DavidMFlynn/SimpleServoCtrl16/SimpleServoPS_PCB/SimpleServoCtrlrA.sch.pdf

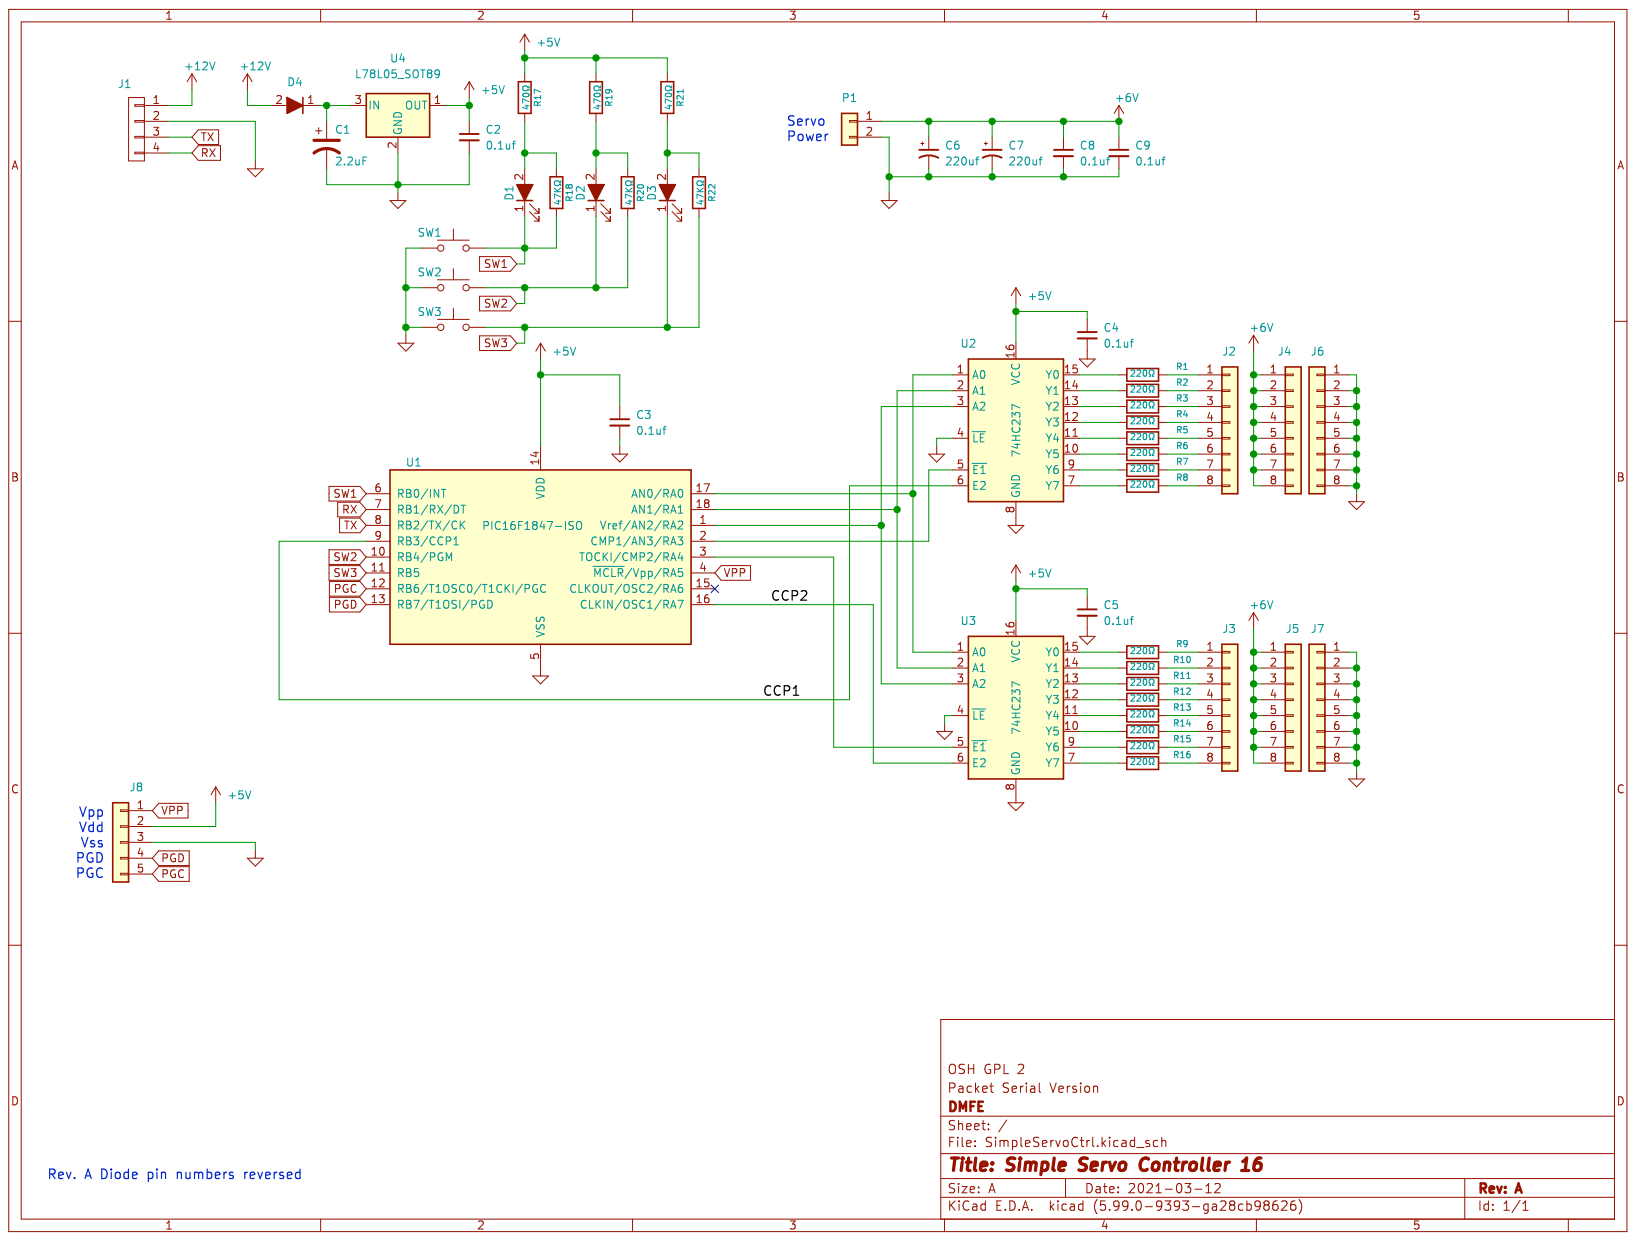
[picture p1: page 1]
