DavidMFlynn/SimpleServoCtrl16/SimpleServoPCB/SimpleServoCtrlTop.pdf

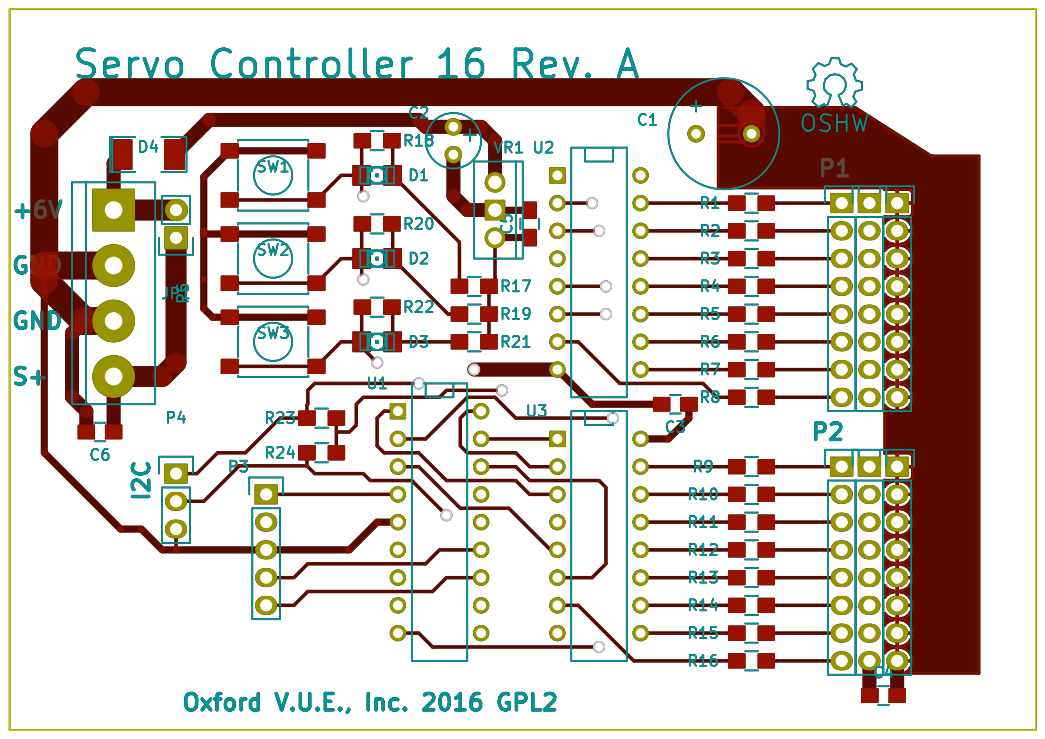
[picture p2: page 1]
