DavidMFlynn/SimpleServoCtrl16/SimpleServoPS_PCB/SimpleServoCtrl.sch.pdf

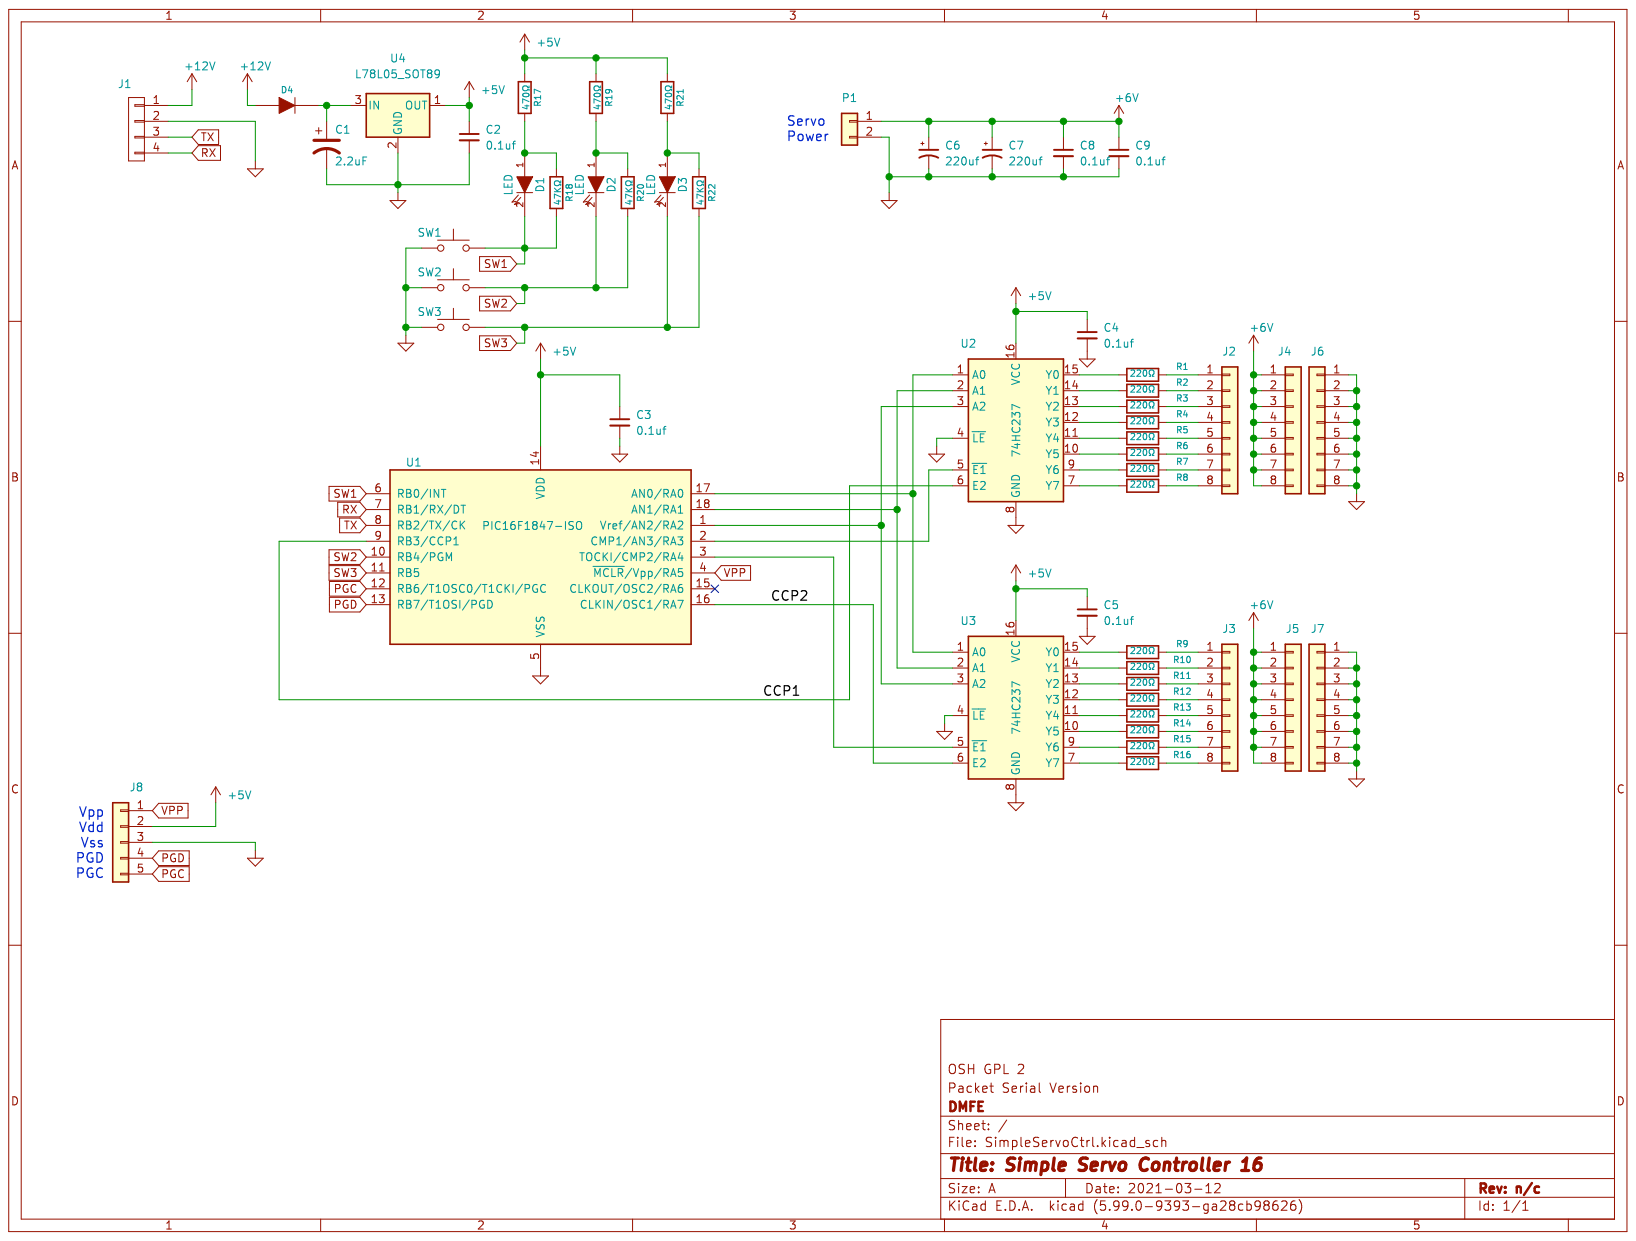
[picture p3: page 1]
