DavidMFlynn/SimpleServoCtrl16/SimpleServoPCB/SimpleServoCtrl.sch.pdf

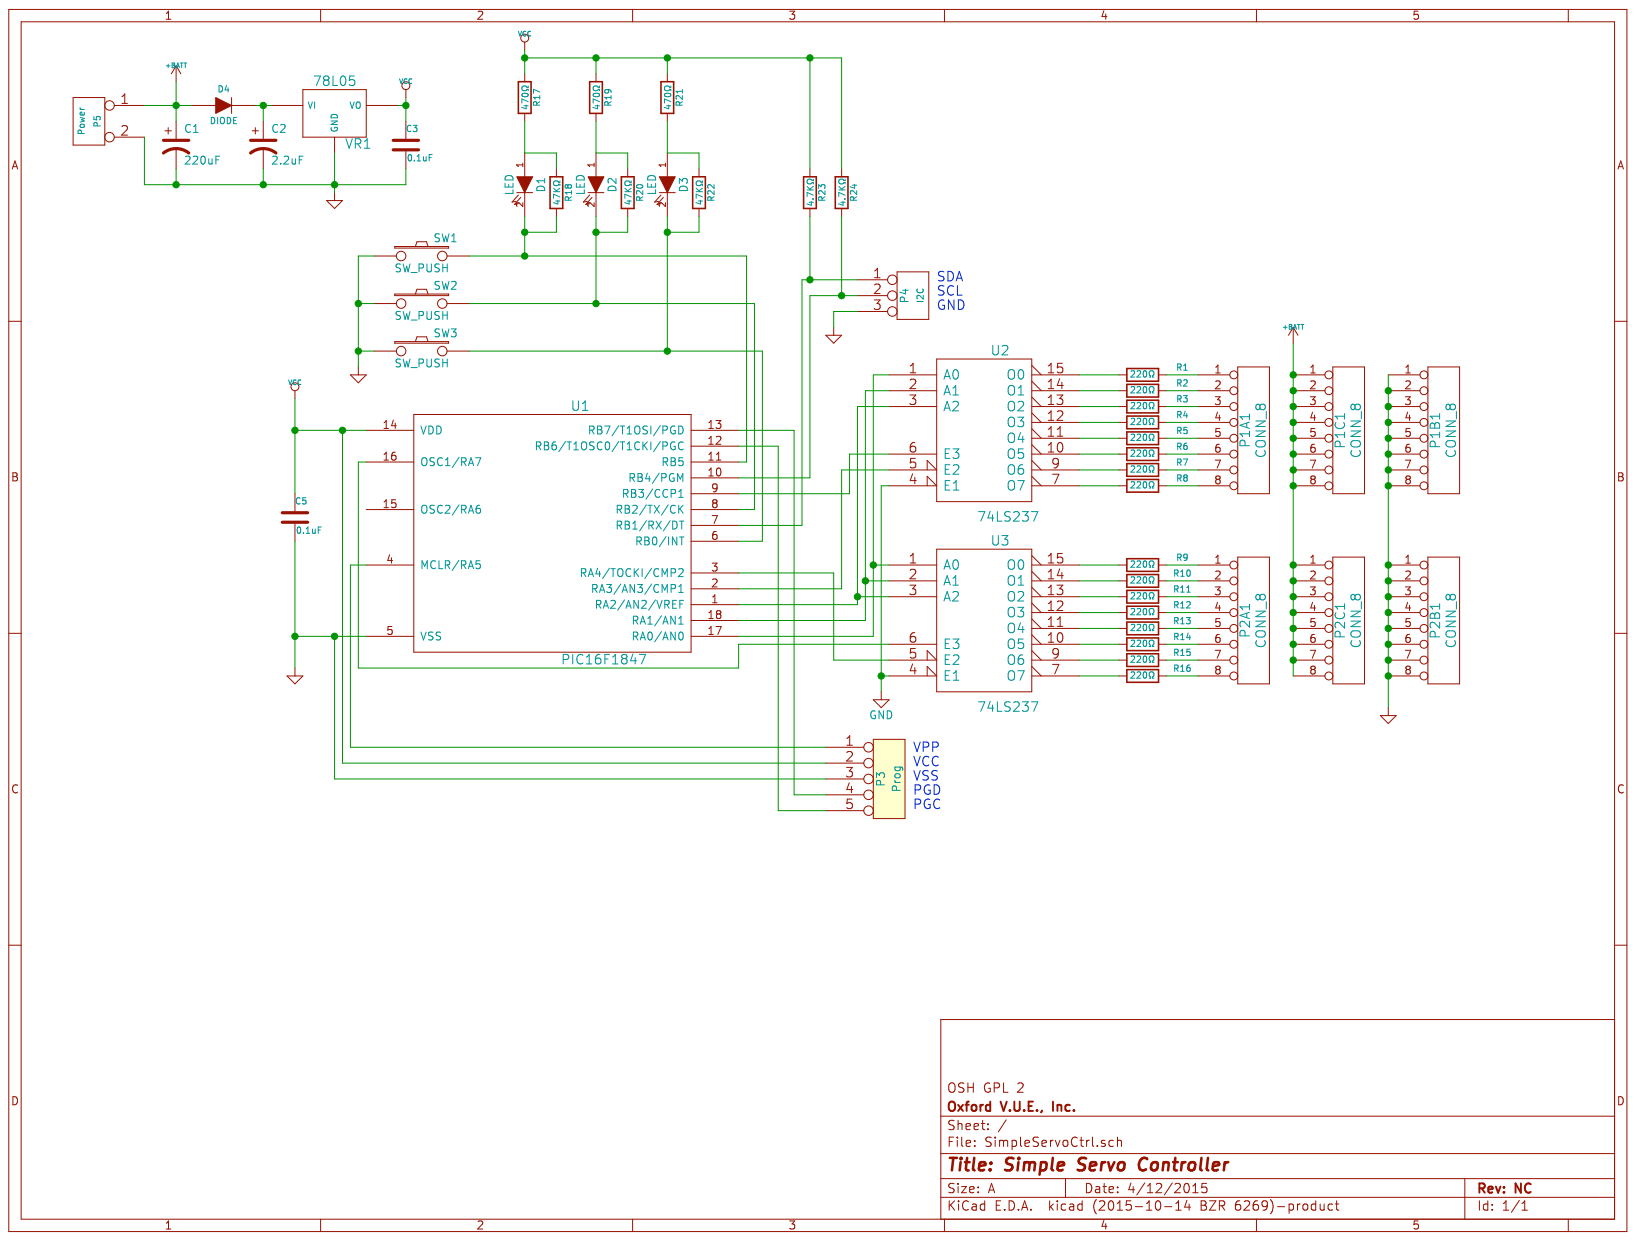
[picture p4: page 1]
