DavidMFlynn/SimpleServoCtrl16/SimpleServoPS_PCB/SimpleServoCtrl.kicad_pcb

## KiCad design SimpleServoPS_PCB/SimpleServoCtrl.kicad_pcb (2021-04-02)

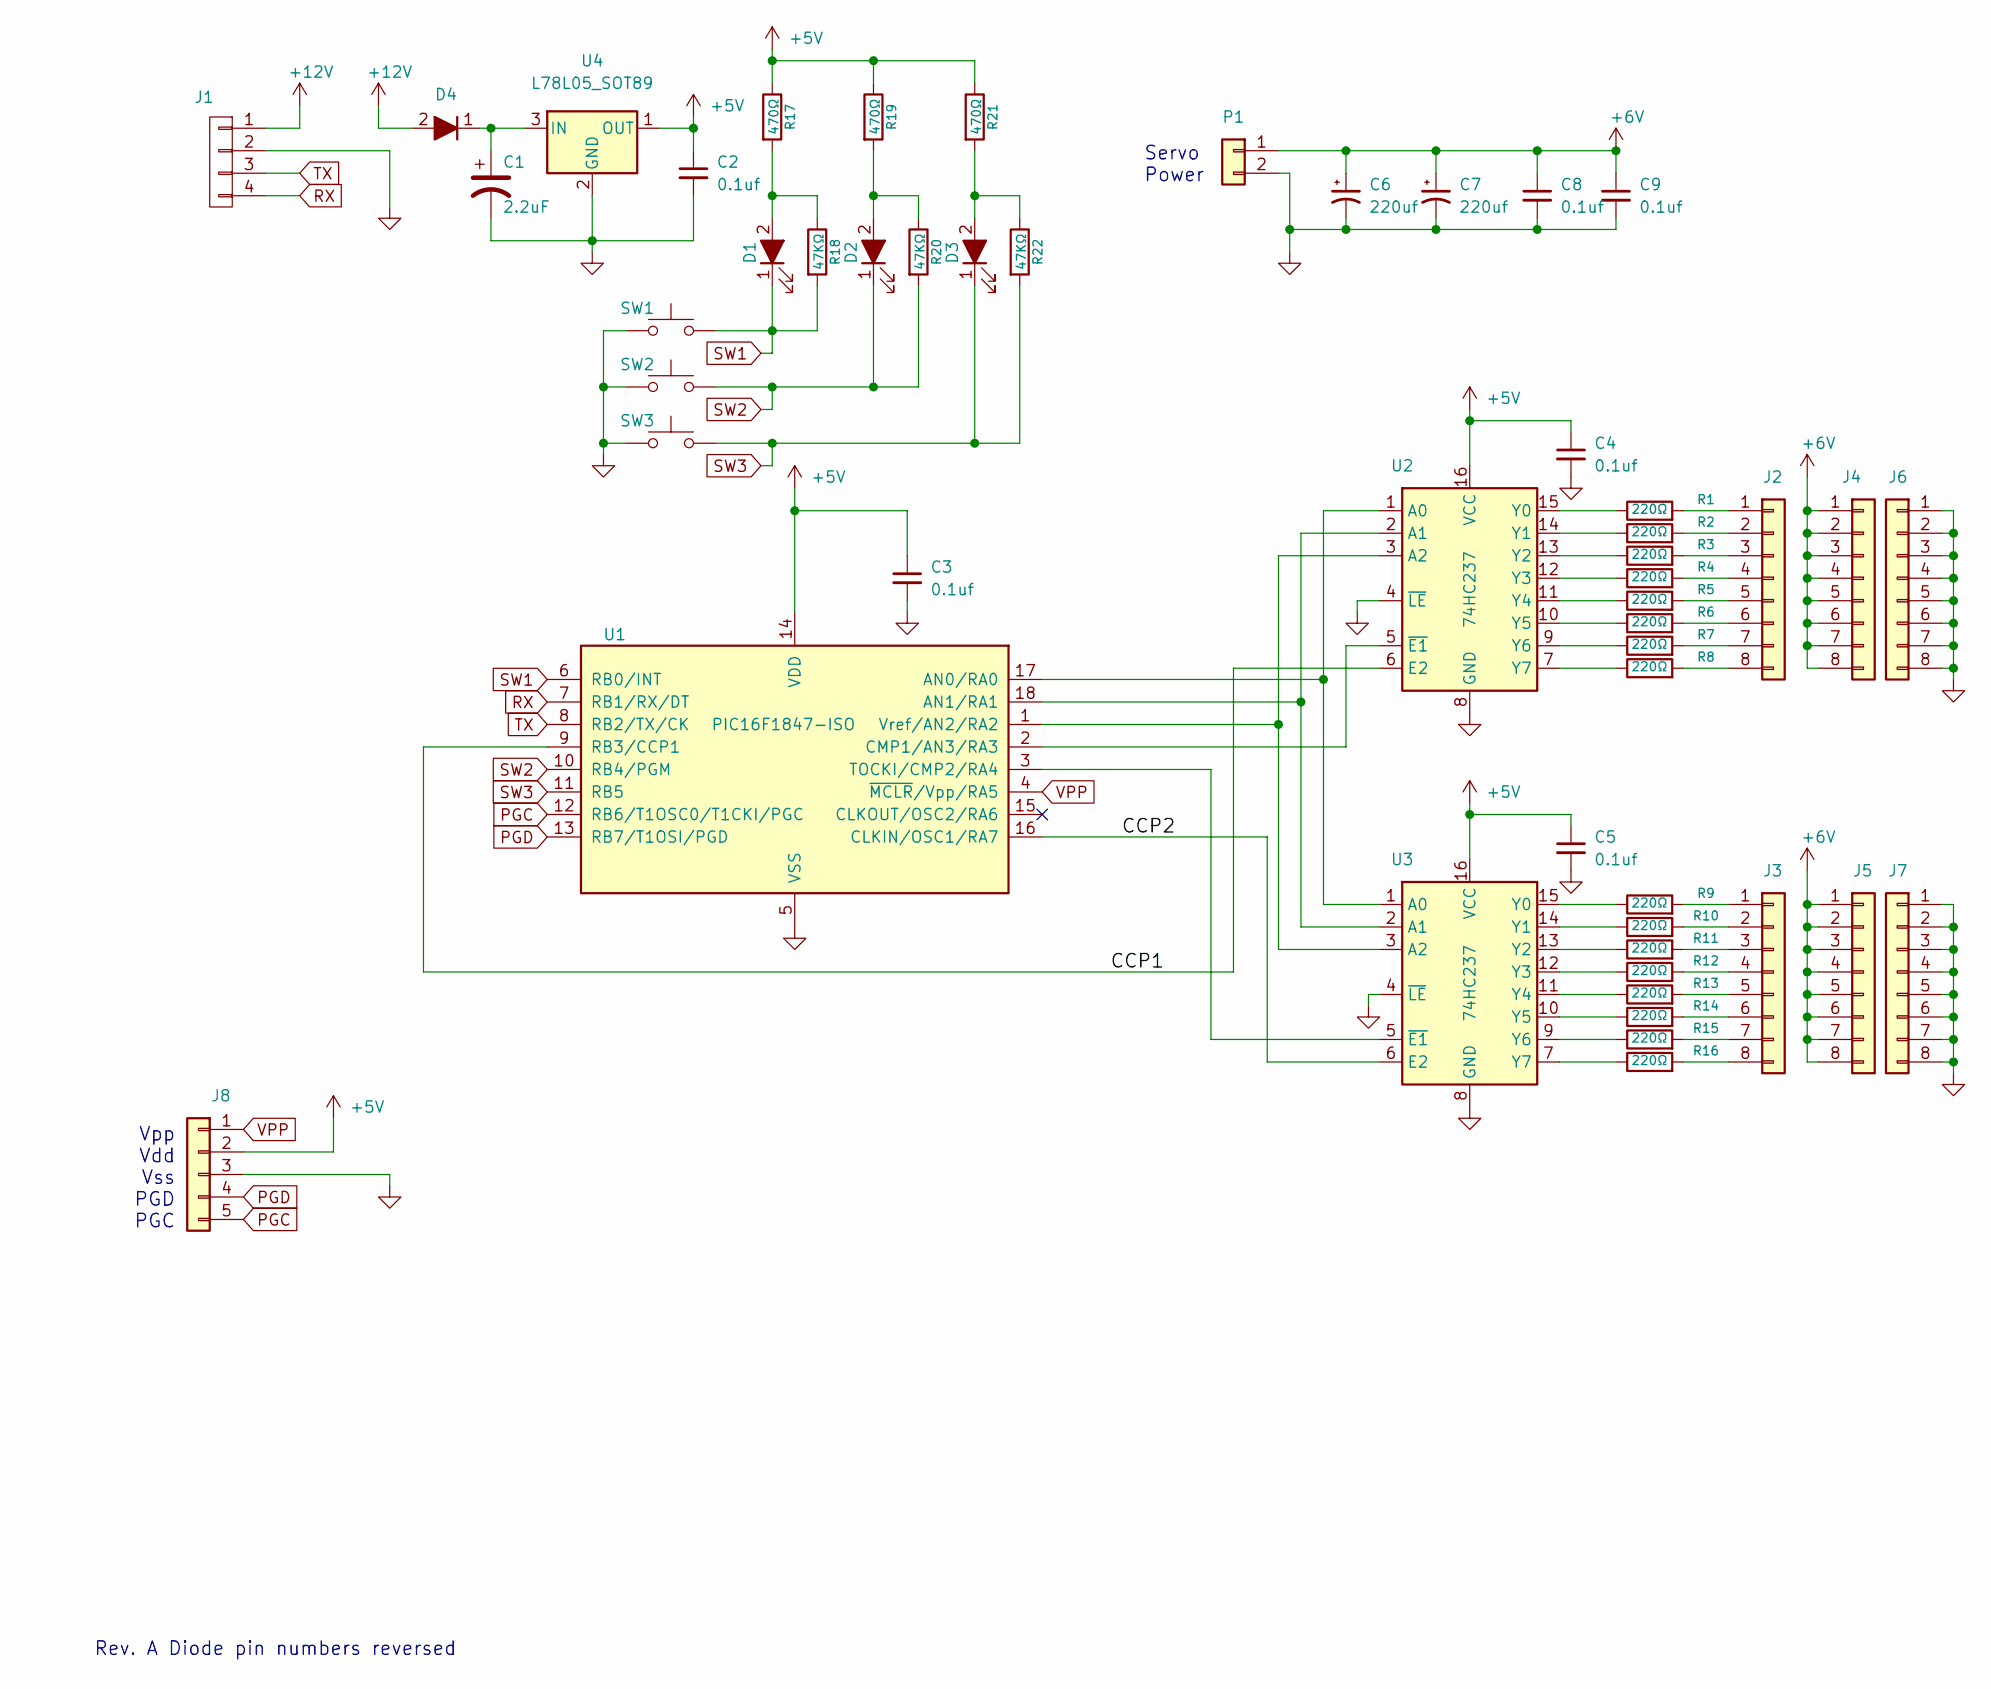
[picture p5: schematic SimpleServoCtrl.kicad_sch, Simple Servo Controller 16]

Parts:
C1: 2.2uF; CP_Radial_D5.0mm_P2.00mm
C2, C3, C4, C5, C8, C9: 0.1uf; C_0805_2012Metric_Pad1.18x1.45mm_HandSolder
C6, C7: 220uf; CP_Radial_D10.0mm_P5.00mm
D1, D2, D3: LED
D4: D_Filled
J1: CONN_01X04; Molex_KK-254_AE-6410-04A_1x04_P2.54mm_Vertical
J2, J3, J4, J5, J6, J7: Conn_01x08; PinHeader_1x08_P2.54mm_Vertical
J8: Conn_01x05; PinHeader_1x05_P2.54mm_Vertical
P1: Conn_01x02; PhoenixContact_MSTBVA_2,5_2-G-5,08_1x02_P5.08mm_Vertical
R1, R2, R3, R4, R5, R6, R7, R8, R9, R10, R11, R12, R13, R14, R15, R16: 220Ω; R_0805_2012Metric_Pad1.20x1.40mm_HandSolder
R17, R19, R21: 470Ω; R_0805_2012Metric_Pad1.20x1.40mm_HandSolder
R18, R20, R22: 47KΩ; R_0805_2012Metric_Pad1.20x1.40mm_HandSolder
SW1, SW2, SW3: SW_Push; SW_SPST_FSMSM
U1: PIC16F1847-ISO; SOIC-18W_7.5x11.6mm_P1.27mm
U2, U3: 74HC237; SO-16_5.3x10.2mm_P1.27mm
U4: L78L05_SOT89; SOT-89-3

Connections:
+5V: C2.1, C3.1, C4.1, C5.1, J8.2, R17.1, R19.1, R21.1, U1.14 (VDD), U2.16 (VCC), U3.16 (VCC), U4.1 (OUT)
+6V: C6.1, C7.1, C8.1, C9.1, J4.1, J4.2, J4.3, J4.4, J4.5, J4.6, J4.7, J4.8, J5.1, J5.2, J5.3, J5.4, J5.5, J5.6, J5.7, J5.8, P1.1
+12V: D4.2 (A), J1.1
/CCP1: U1.9 (RB3/CCP1), U2.6 (E2)
/CCP2: U1.16 (CLKIN/OSC1/RA7), U3.6 (E2)
GND: C1.2, C2.2, C3.2, C4.2, C5.2, C6.2, C7.2, C8.2, C9.2, J1.2, J6.1, J6.2, J6.3, J6.4, J6.5, J6.6, J6.7, J6.8, J7.1, J7.2, J7.3, J7.4, J7.5, J7.6, J7.7, J7.8, J8.3, P1.2, SW1.1, SW2.1, SW3.1, U1.5 (VSS), U2.4 (~LE), U2.8 (GND), U3.4 (~LE), U3.8 (GND), U4.2 (GND)
unnamed: C1.1, D4.1 (K), U4.3 (IN)
unnamed: J2.1, R1.2
unnamed: J2.2, R2.2
unnamed: J2.3, R3.2
unnamed: J2.4, R4.2
unnamed: J2.5, R5.2
unnamed: J2.6, R6.2
unnamed: J2.7, R7.2
unnamed: J2.8, R8.2
unnamed: J3.1, R9.2
unnamed: J3.2, R10.2
unnamed: J3.3, R11.2
unnamed: J3.4, R12.2
unnamed: J3.5, R13.2
unnamed: J3.6, R14.2
unnamed: J3.7, R15.2
unnamed: J3.8, R16.2
unnamed: R1.1, U2.15 (Y0)
unnamed: R2.1, U2.14 (Y1)
unnamed: R3.1, U2.13 (Y2)
unnamed: R4.1, U2.12 (Y3)
unnamed: R5.1, U2.11 (Y4)
unnamed: R6.1, U2.10 (Y5)
unnamed: R7.1, U2.9 (Y6)
unnamed: R8.1, U2.7 (Y7)
unnamed: R9.1, U3.15 (Y0)
unnamed: R10.1, U3.14 (Y1)
unnamed: R11.1, U3.13 (Y2)
unnamed: R12.1, U3.12 (Y3)
unnamed: R13.1, U3.11 (Y4)
unnamed: R14.1, U3.10 (Y5)
unnamed: R15.1, U3.9 (Y6)
unnamed: R16.1, U3.7 (Y7)
unnamed: D1.2 (A), R17.2, R18.1
unnamed: D2.2 (A), R19.2, R20.1
unnamed: D3.2 (A), R21.2, R22.1
unnamed: U1.1 (Vref/AN2/RA2), U2.3 (A2), U3.3 (A2)
unnamed: U1.2 (CMP1/AN3/RA3), U2.5 (~E1)
unnamed: U1.3 (TOCKI/CMP2/RA4), U3.5 (~E1)
unnamed: U1.17 (AN0/RA0), U2.1 (A0), U3.1 (A0)
unnamed: U1.18 (AN1/RA1), U2.2 (A1), U3.2 (A1)
PGC: J8.5, U1.12 (RB6/T1OSC0/T1CKI/PGC)
PGD: J8.4, U1.13 (RB7/T1OSI/PGD)
RX: J1.4, U1.7 (RB1/RX/DT)
SW1: D1.1 (K), R18.2, SW1.2, U1.6 (RB0/INT)
SW2: D2.1 (K), R20.2, SW2.2, U1.10 (RB4/PGM)
SW3: D3.1 (K), R22.2, SW3.2, U1.11 (RB5)
TX: J1.3, U1.8 (RB2/TX/CK)
VPP: J8.1, U1.4 (~MCLR~/Vpp/RA5)

Notes on the sheet:
Vpp Vdd Vss PGD PGC
Rev. A Diode pin numbers reversed
Servo Power

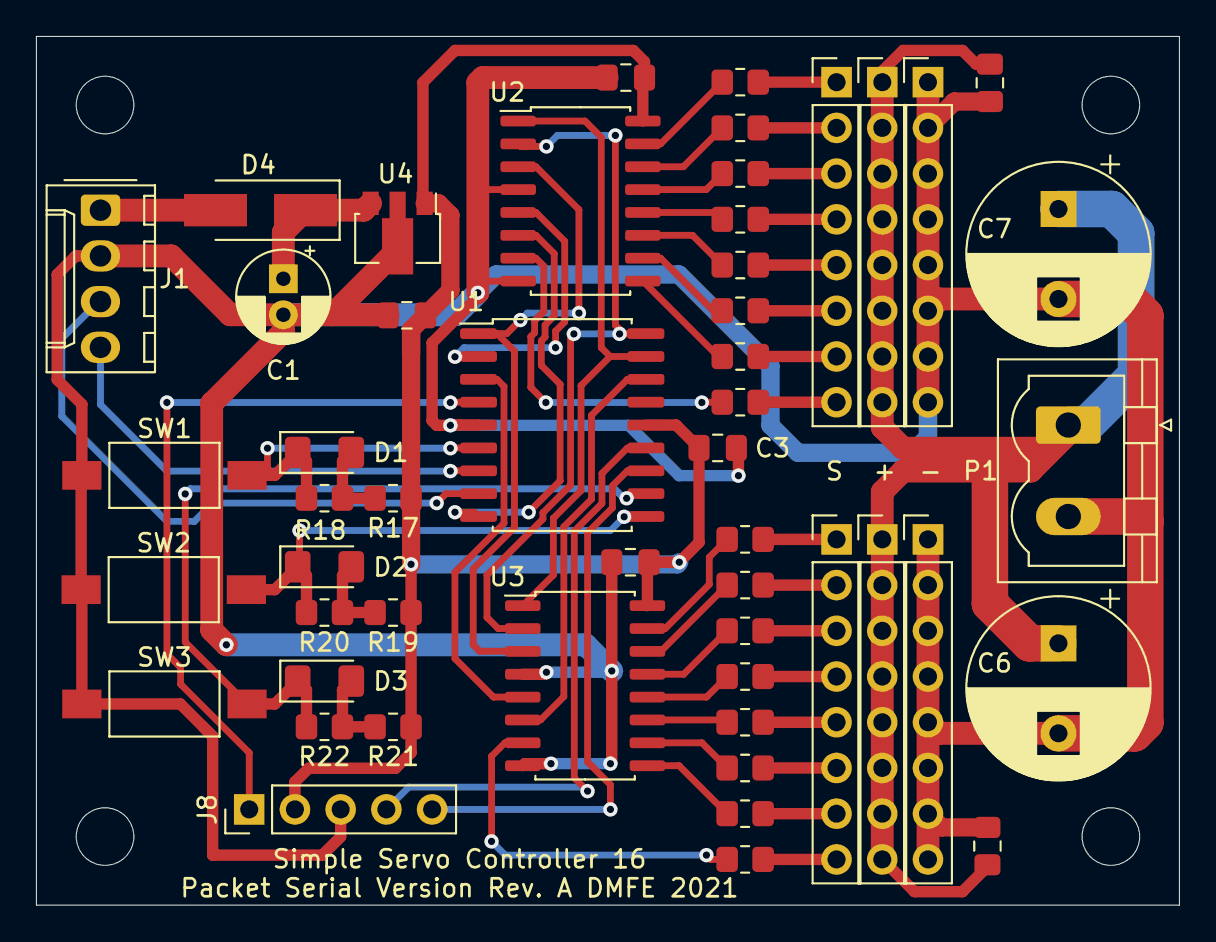
[picture p6: board SimpleServoCtrl.kicad_pcb from above]

Board: 2 copper layers, 63.5 x 48.3 mm, 55 parts (0 on the bottom side), 55 nets.

Other parts of the board:
H1, H2, H3, H4: MountingHole_3.2mm_M3
