DavidMFlynn/SimpleServoCtrl16/(commit log)

2015-11-12 First working code
    [SimpleServoCtrl.kicad_pcb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]
2015-11-20 Worked on I2C Rx/Tx
    Ready to write a master and test the I2C
2021-03-13 Added Packet Serial version
    [SimpleServoCtrl-2021-03-12-15-38-45.sch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]
2021-04-02 Rev A
    [SimpleServoCtrl-B_Cu.gbl, SimpleServoCtrl-B_Mask.gbs, SimpleServoCtrl-B_Silkscreen.gbo, SimpleServoCtrl-Edge_Cuts.gm1, SimpleServoCtrl-F_Cu.gtl, SimpleServoCtrl-F_Mask.gts, SimpleServoCtrl-F_Silkscreen.gto, SimpleServoCtrl.drl]
