DavidMFlynn/SimpleServoCtrl16/(notices)

Notices in the files:
SimpleServoPS_PCB/rescue-backup/SimpleServoCtrl-2021-03-12-15-38-45.sch:
OSH GPL 2
SimpleServoPCB/SimpleServoCtrl.kicad_pcb:
Oxford V.U.E., Inc. 2016 GPL2
